nelson-phillips/pressure-sensor-kit/README.md

# pressure-sensor-kit
This is an air pressure kit primarily to measure the pressure field acting on a car. Based around the Arduino nano it has 4 analog pressure transducers for measuring the gauge pressure and a BMP280 Barometric sensor to give a absolute measurement reference. Additional module can be used to increase the number of sensors or memory.
